akifmohamed/PhoenixCore-M2026-165/docs/proofs/06_openroad_gui_overview.png

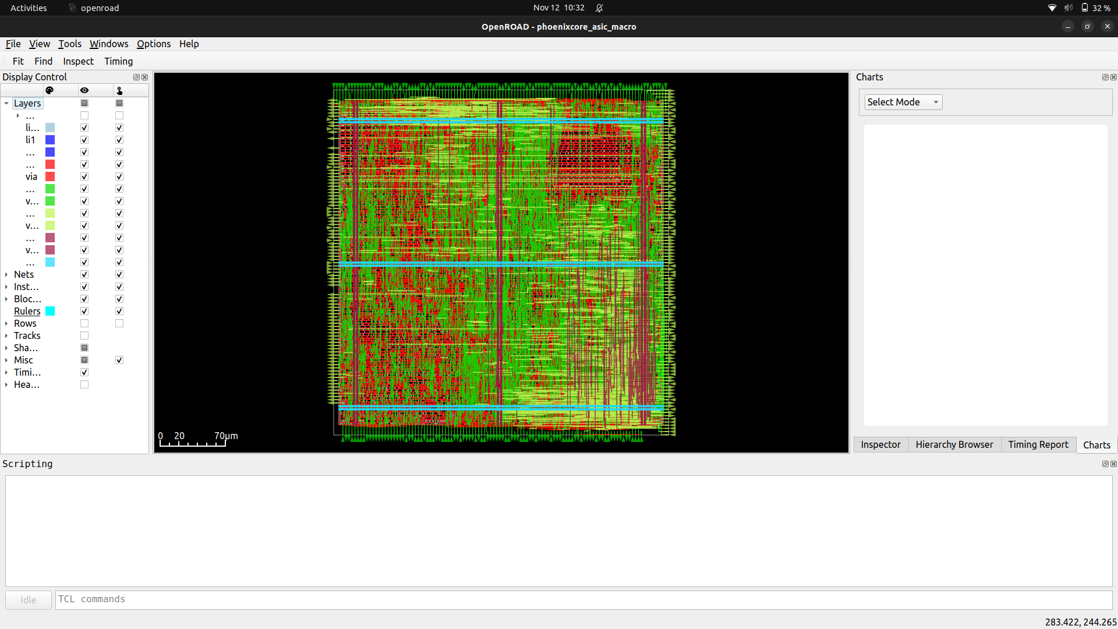
docs/proofs/06_openroad_gui_overview.png
