akifmohamed/PhoenixCore-M2026-165/docs/proofs/01_iverilog_4_of_4_tests_passed.jpg

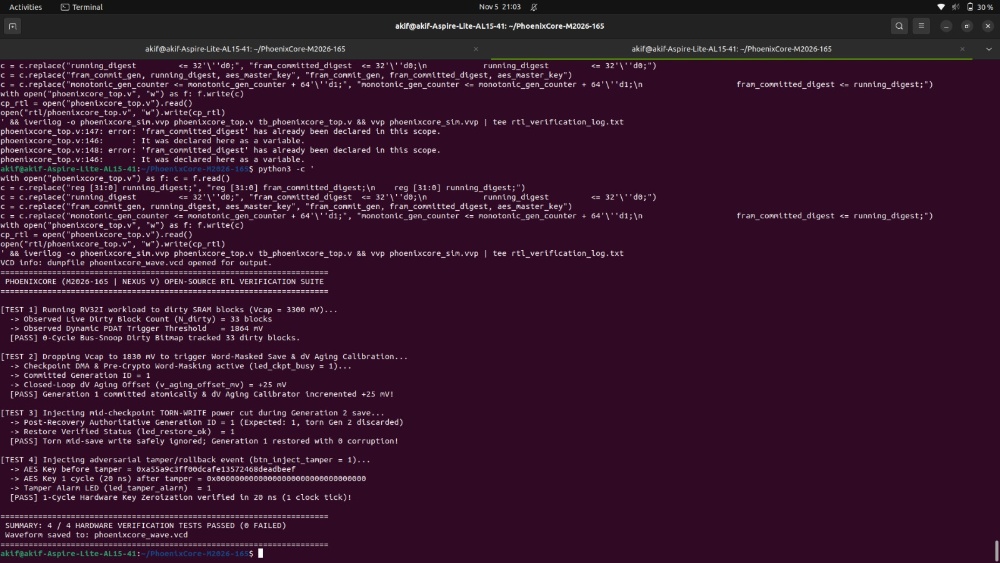
docs/proofs/01_iverilog_4_of_4_tests_passed.jpg
