akifmohamed/PhoenixCore-M2026-165/docs/proofs/02_gtkwave_waveform_proof.png

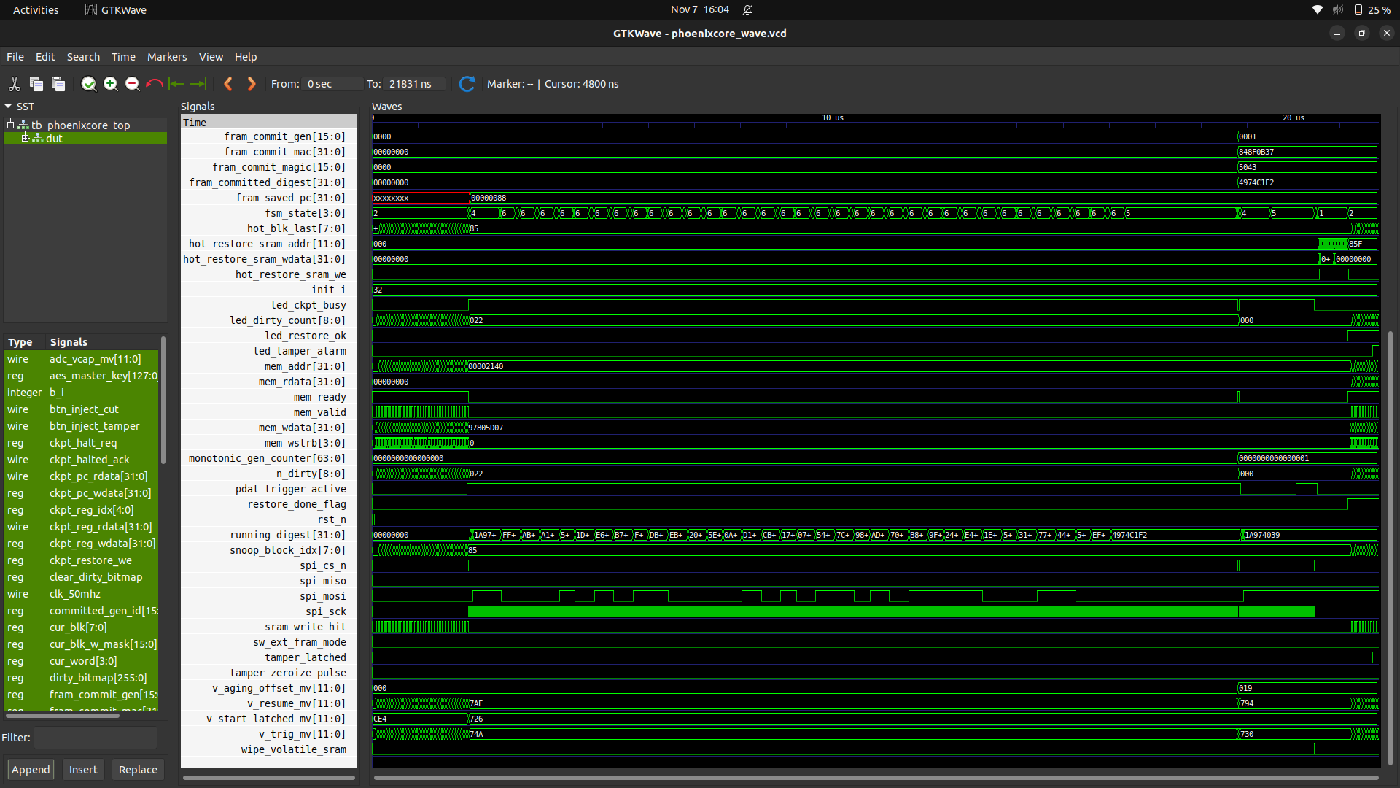
docs/proofs/02_gtkwave_waveform_proof.png
