akifmohamed/PhoenixCore-M2026-165/docs/proofs/03_yosys_asic_and_artix7_synthesis.png

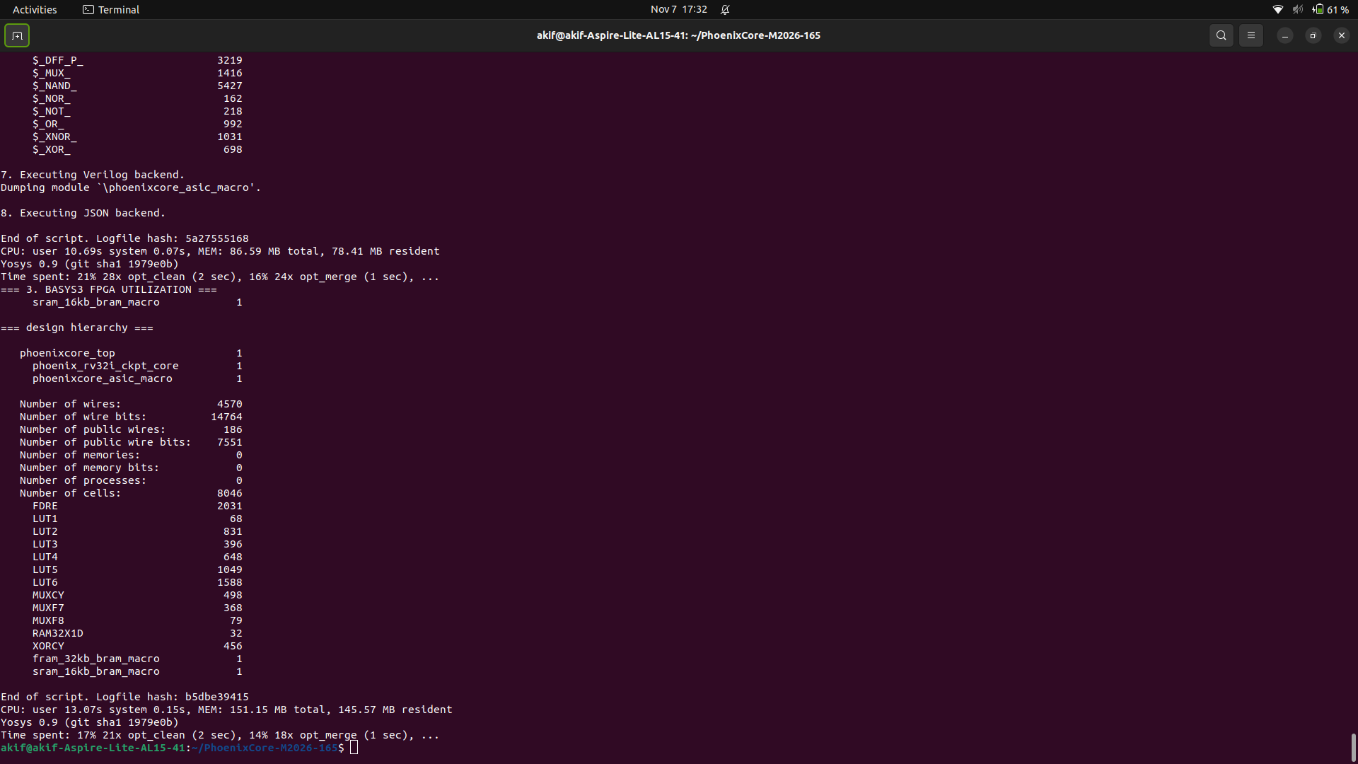
docs/proofs/03_yosys_asic_and_artix7_synthesis.png
