akifmohamed/PhoenixCore-M2026-165/docs/proofs/04_openlane2_stage78_drc_lvs_sta_passed.jpg

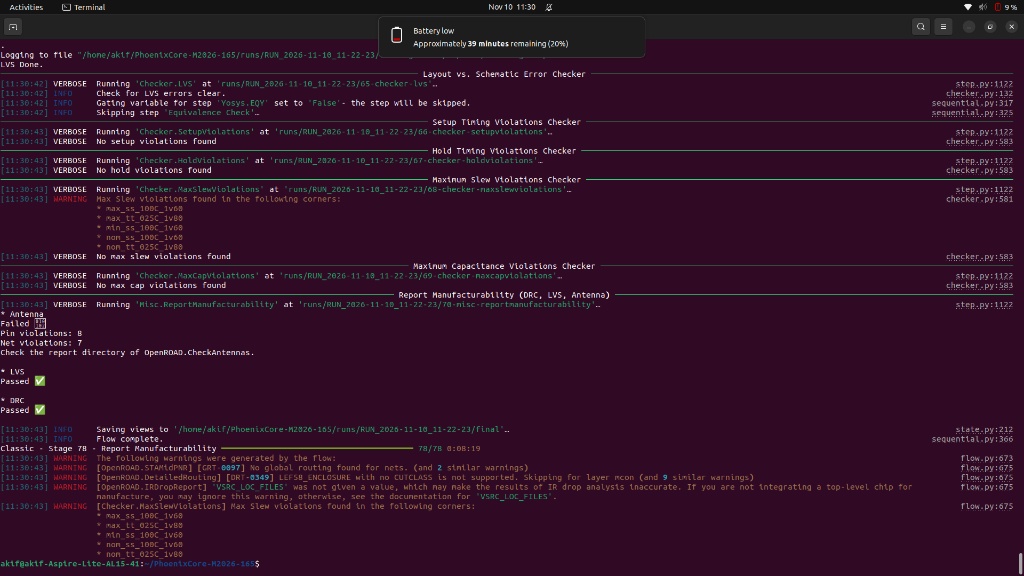
docs/proofs/04_openlane2_stage78_drc_lvs_sta_passed.jpg
