akifmohamed/PhoenixCore-M2026-165/docs/proofs/05_klayout_sky130a_black_bg.png

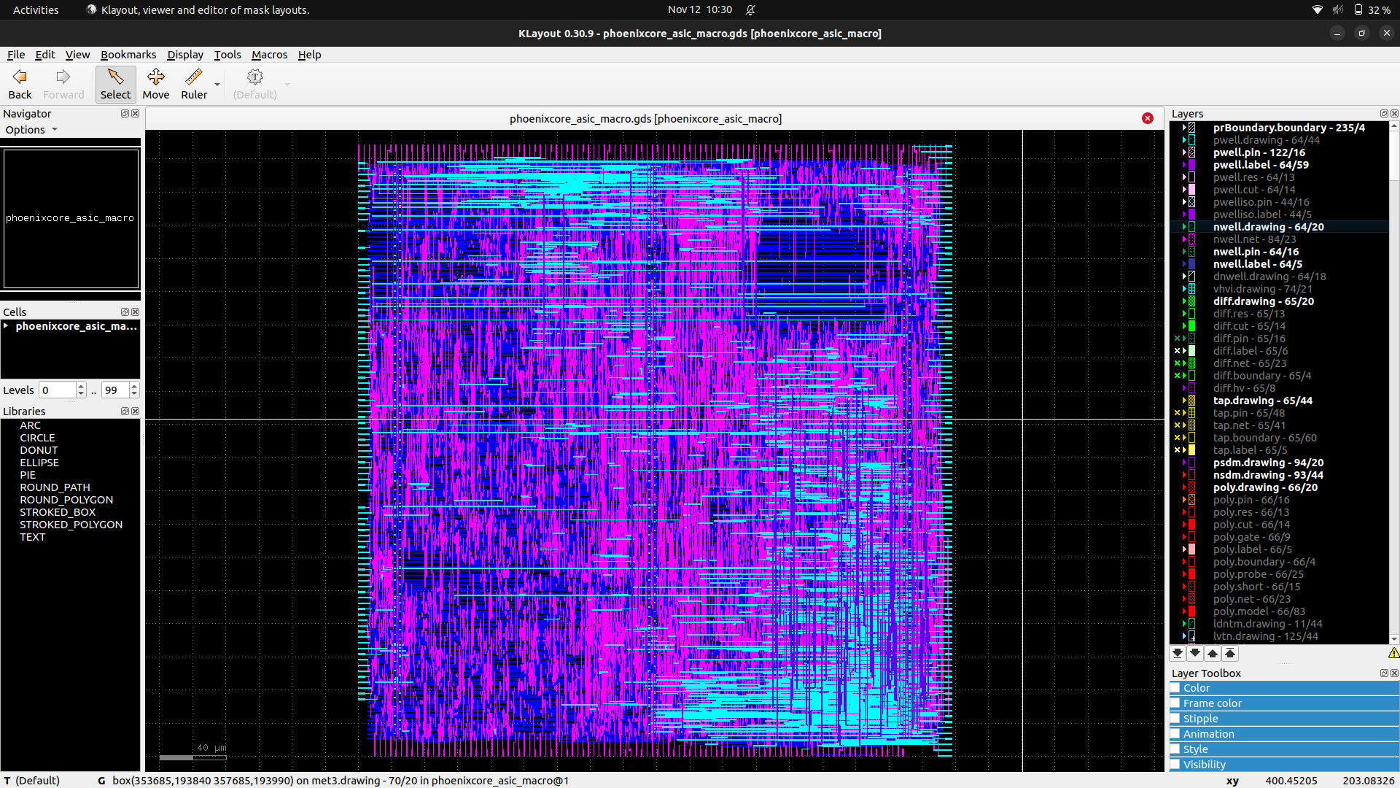
docs/proofs/05_klayout_sky130a_black_bg.png
