akifmohamed/PhoenixCore-M2026-165/docs/proofs/07_openroad_full_die_layout.png

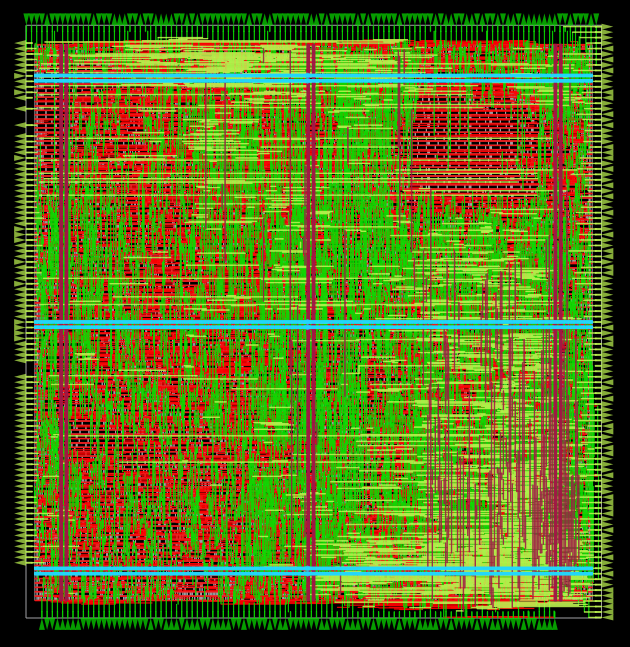
docs/proofs/07_openroad_full_die_layout.png
