akifmohamed/PhoenixCore-M2026-165/docs/proofs/08_openroad_mid_zoom_pdn_routing.png

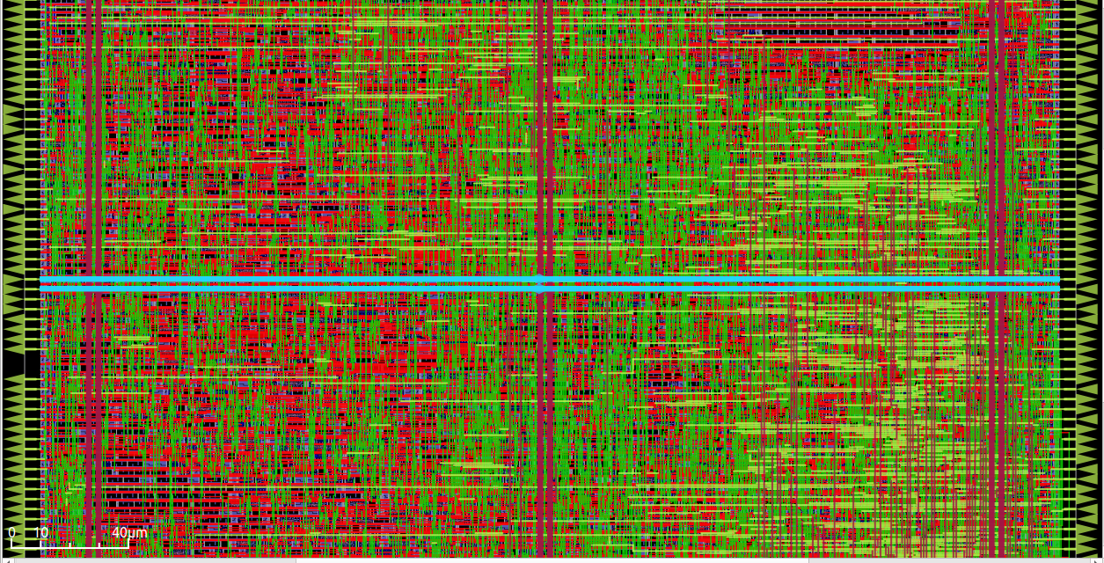
docs/proofs/08_openroad_mid_zoom_pdn_routing.png
