akifmohamed/PhoenixCore-M2026-165/docs/proofs/09_openroad_1um_cell_cts_hold_zoom.png

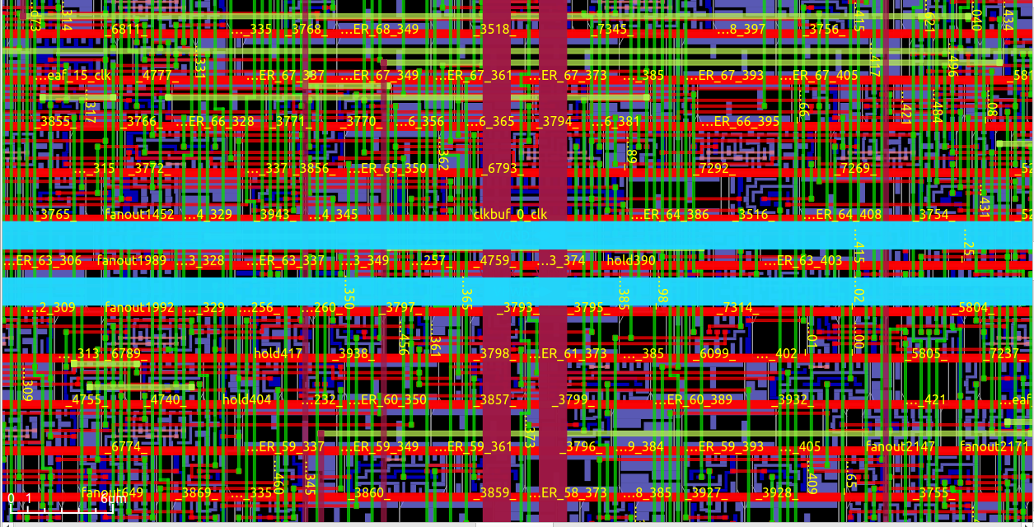
docs/proofs/09_openroad_1um_cell_cts_hold_zoom.png
