akifmohamed/PhoenixCore-M2026-165/(commit log)

2026-11-05 feat(sim,docs): add Round-2 DPR and 1000-trial 3-way brownout & cap-aging simulator
    [phoenixcore_brownout_sim.py]
2026-11-05 feat(rtl,asic): implement PhoenixCore SoC with PC-WMC, SH-PDAT dV calibrator, and 1-cycle zeroizer
2026-11-05 test(tb,fpga): add self-checking 4-stage Verilog testbench, Basys3 XDC, and Ubuntu flow
2026-11-07 verify(rtl,synth): pass 4/4 Icarus Verilog brownout/tamper tests and complete Yosys synthesis
    [phoenixcore_top.v, tb_phoenixcore_top.v]
2026-11-10 Add live Ubuntu GTKWave, Yosys, OpenLane 2 Stage 78, and KLayout GDSII image proofs to repo and README
2026-11-12 Add OpenROAD full-die, 1-um CTS/hold cell zoom, KLayout GDSII .png proofs, and updated synthesis logs
2026-11-12 Update DPR, Review PPTX, OpenROAD/KLayout .png silicon proofs, BOM, and verified synthesis logs
2026-11-12 Fix Test 3 torn-write MAC restore check (4/4 PASS) and 0x021 dirty block hex label
    [phoenixcore_asic_macro.v]
2026-11-12 Fix wire assignment in phoenixcore_asic_macro.v and populate 4/4 rtl_verification_log.txt
    [phoenixcore_asic_macro.v]
2026-11-14 Synchronize all RTL/XDC/FPGA/DPR files, fix README image links, and remove nested duplicate folder
    [basys3_phoenixcore.xdc, phoenixcore_asic_macro.v, phoenixcore_brownout_sim.py, phoenixcore_top.v, tb_phoenixcore_top.v]
2026-11-14 Revise project details and add new documentation
    Updated README.md to reflect changes in project details, including domain focus and added new files for FPGA prototype and telemetry.
